senexger/shotexpress-spur-0/CAD/Track/preview/turnaround.jpg

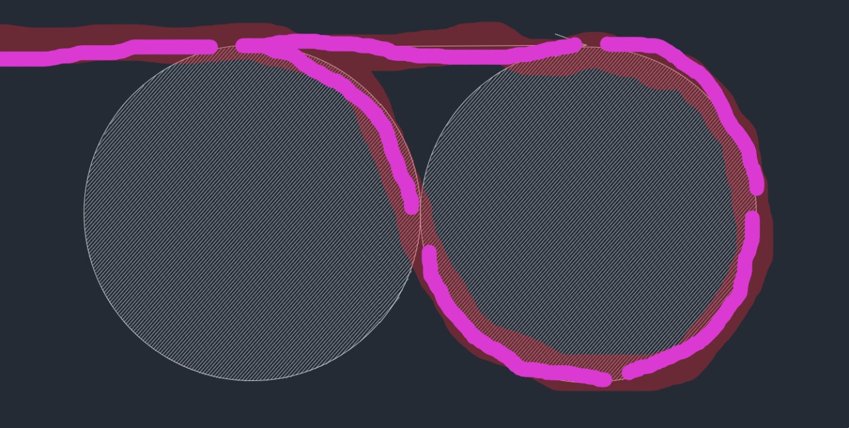
CAD/Track/preview/turnaround.jpg
