senexger/shotexpress-spur-0/CAD/Track/preview/weiche_change.png

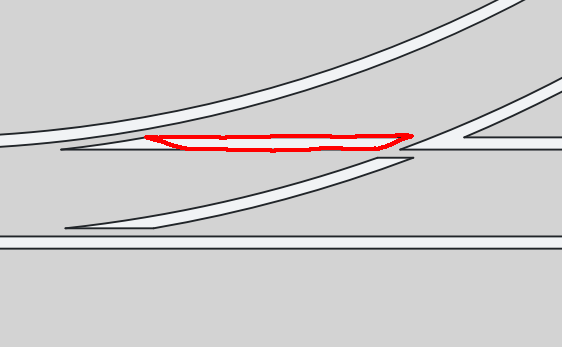
CAD/Track/preview/weiche_change.png
