senexger/shotexpress-spur-0/CAD/Wagon/coal_wagon_sketch.jpeg

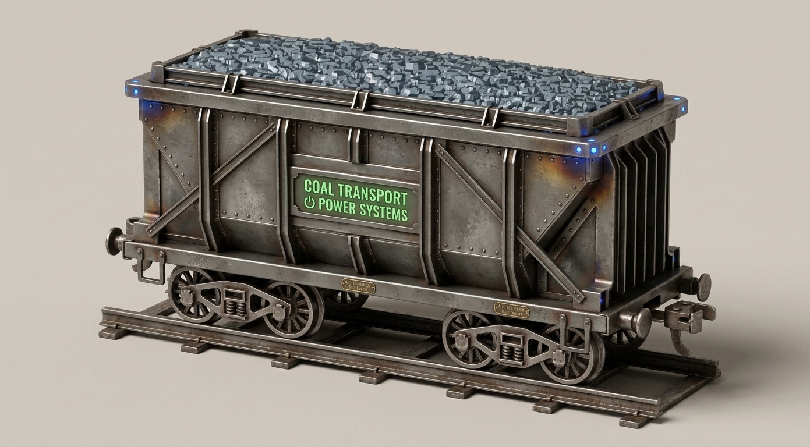
CAD/Wagon/coal_wagon_sketch.jpeg
