senexger/shotexpress-spur-0/CAD/Wagon/connector.jpg

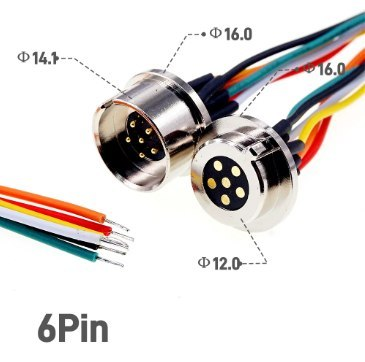
CAD/Wagon/connector.jpg
