senexger/shotexpress-spur-0/CAD/Wagon/flanschkugellager.jpg

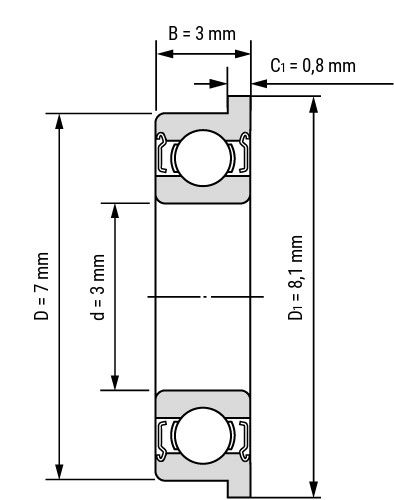
CAD/Wagon/flanschkugellager.jpg
