senexger/shotexpress-spur-0/CAD/Wagon/shot_wagon_sketch.jpeg

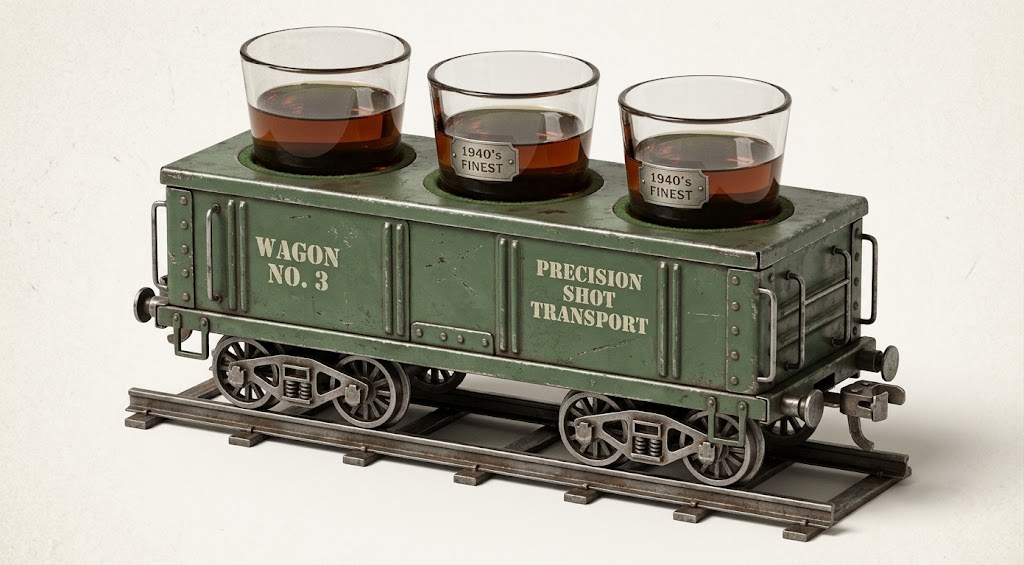
CAD/Wagon/shot_wagon_sketch.jpeg
