senexger/shotexpress-spur-0/CAD/Track/laser/kurve_90.dxf

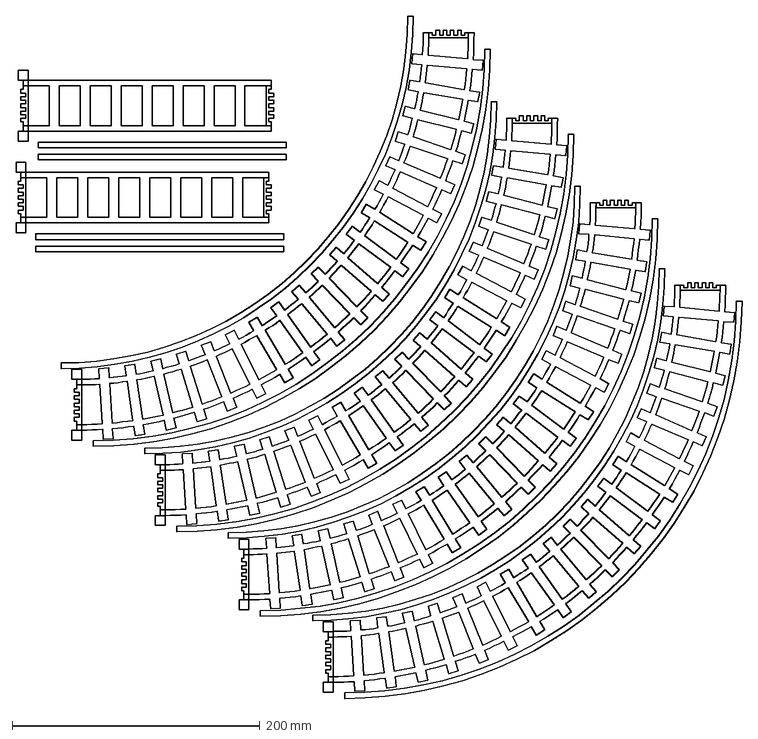
[picture p9: CAD file, 2026-11-03]
CAD/Track/laser/kurve_90.dxf
585.7 x 550.2 mm
