senexger/shotexpress-spur-0/CAD/Track/schiene.FCStd

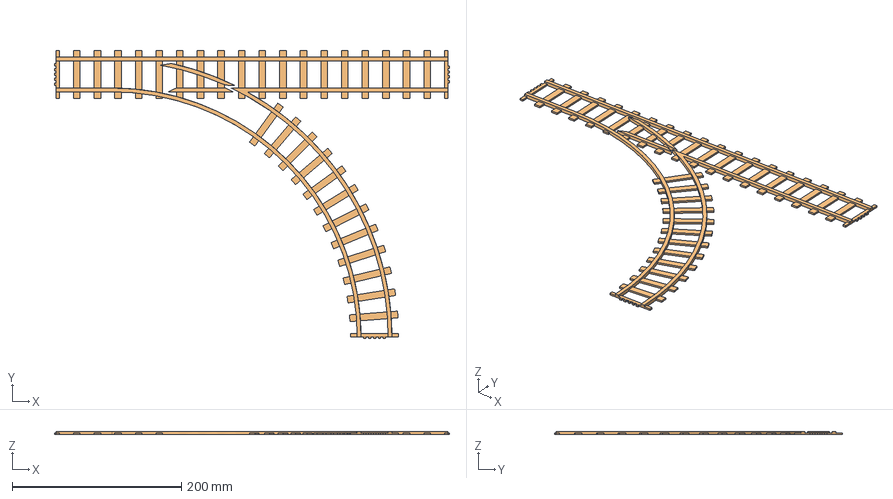
[picture p10: CAD file, 2026-11-03]
CAD/Track/schiene.FCStd
466.5 x 340.5 x 4.00 mm
Steckschwelle_male
