senexger/shotexpress-spur-0/CAD/Wagon/ModuleCoal.stl

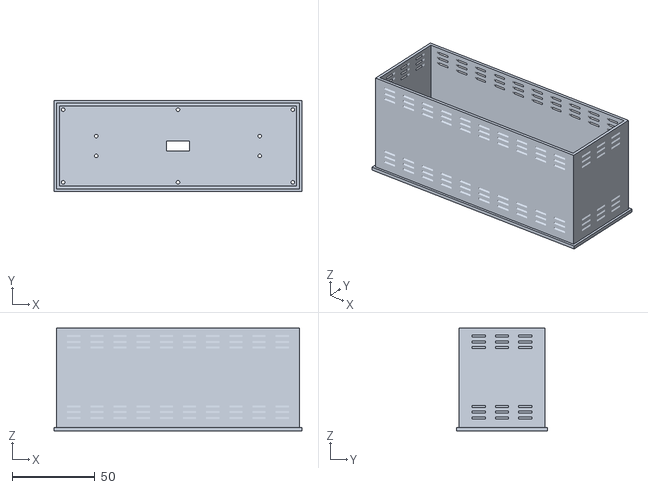
[picture p11: CAD file, 2026-11-03]
CAD/Wagon/ModuleCoal.stl
150.0 x 55.0 x 62.0
