senexger/shotexpress-spur-0/CAD/Wheelset/radsatz.FCStd

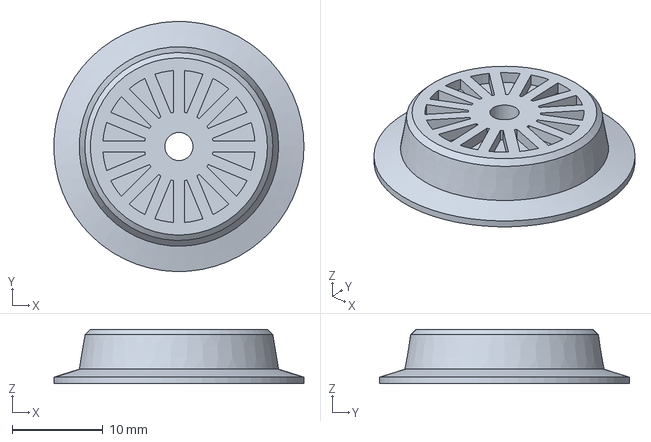
[picture p12: CAD file, 2026-11-03]
CAD/Wheelset/radsatz.FCStd
27.6 x 27.6 x 6.00 mm
