senexger/shotexpress-spur-0/CAD/Wheelset/stl/achse.stl

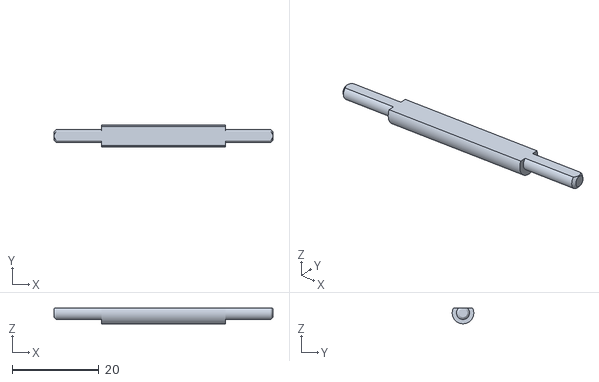
[picture p13: CAD file, 2026-11-03]
CAD/Wheelset/stl/achse.stl
50.6 x 5.00 x 3.60
