senexger/shotexpress-spur-0/CAD/Track/laser/gerade120.dxf

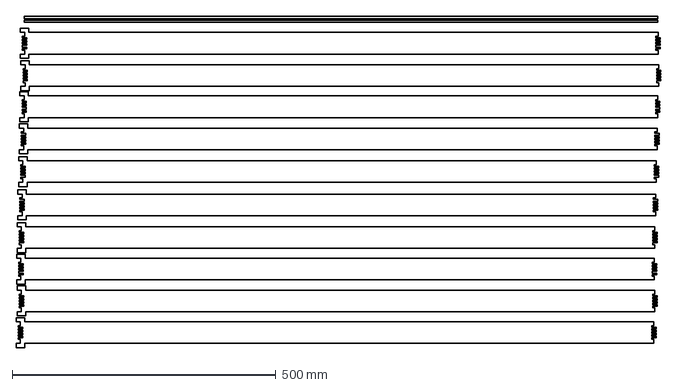
[picture p14: CAD file, 2026-11-03]
CAD/Track/laser/gerade120.dxf
1220.8 x 627.5 mm
