senexger/shotexpress-spur-0/CAD/Wagon/ModuleCoalLid.stl

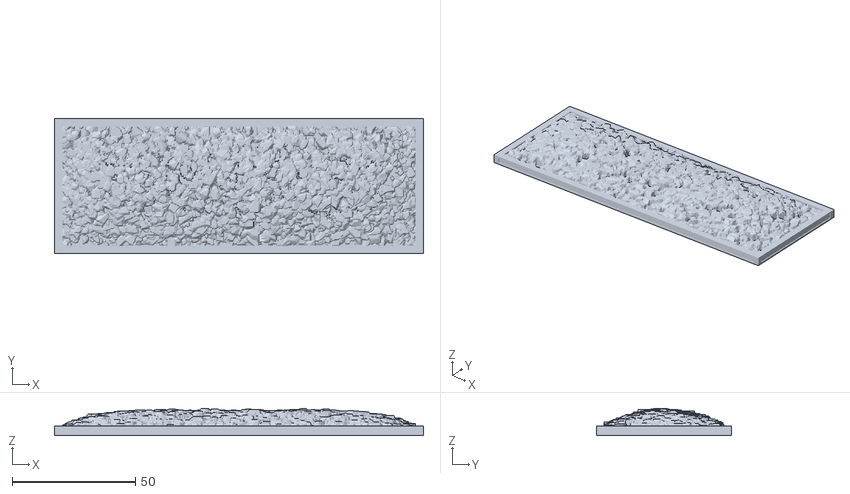
[picture p15: CAD file, 2026-11-03]
CAD/Wagon/ModuleCoalLid.stl
150.0 x 55.0 x 11.1
