senexger/shotexpress-spur-0/CAD/Wheelset/stl/radsatz-RadRad_Dekor_Vertiefung.stl

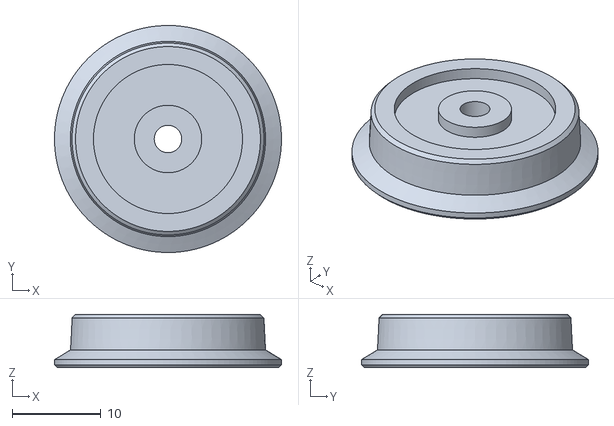
[picture p16: CAD file, 2026-11-03]
CAD/Wheelset/stl/radsatz-RadRad_Dekor_Vertiefung.stl
25.6 x 25.6 x 6.00
