senexger/shotexpress-spur-0/CAD/Track/laser/Kurve.dxf

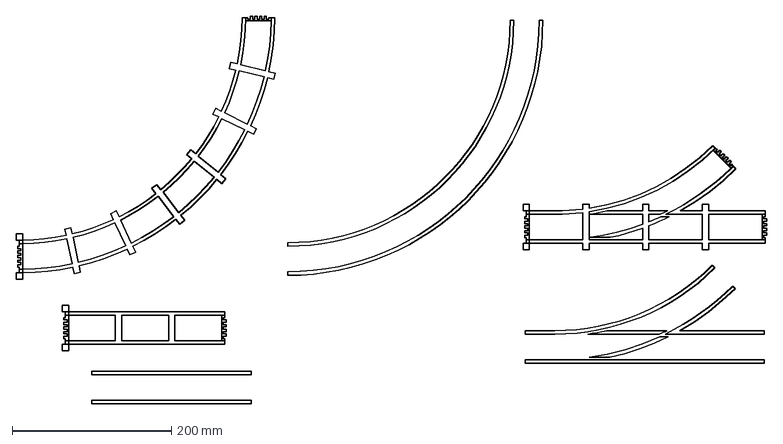
[picture p17: CAD file, 2026-11-03]
CAD/Track/laser/Kurve.dxf
942.2 x 486.9 mm
