senexger/shotexpress-spur-0/CAD/Wagon/ModuleCoal3Lid.stl

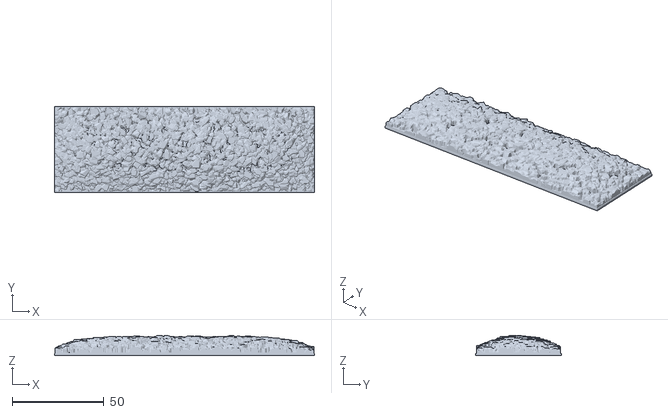
[picture p18: CAD file, 2026-11-03]
CAD/Wagon/ModuleCoal3Lid.stl
141.9 x 46.9 x 11.1
