senexger/shotexpress-spur-0/CAD/Wheelset/stl/radsatz-Rad.stl

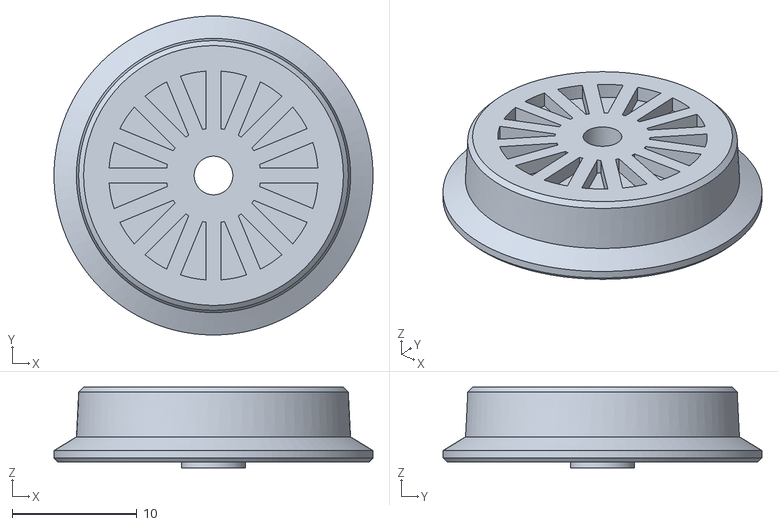
[picture p19: CAD file, 2026-11-03]
CAD/Wheelset/stl/radsatz-Rad.stl
25.6 x 25.6 x 6.50
