senexger/shotexpress-spur-0/CAD/Wagon/ModuleShot.stl

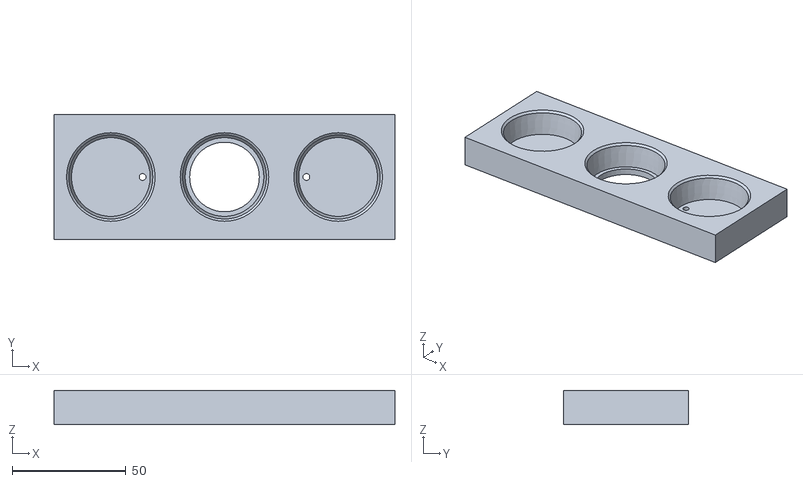
[picture p20: CAD file, 2026-11-03]
CAD/Wagon/ModuleShot.stl
150.0 x 55.0 x 15.0
