senexger/shotexpress-spur-0/CAD/Wheelset/stl/radsatz-Achse.stl

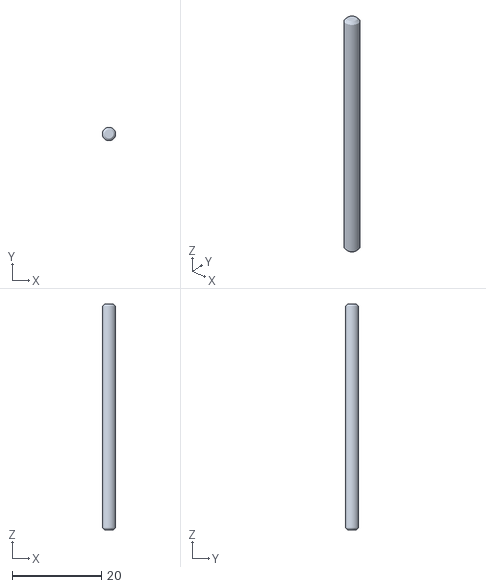
[picture p21: CAD file, 2026-11-03]
CAD/Wheelset/stl/radsatz-Achse.stl
3.00 x 3.00 x 50.6
