senexger/shotexpress-spur-0/CAD/Wagon/ModuleCoalDecorated.stl

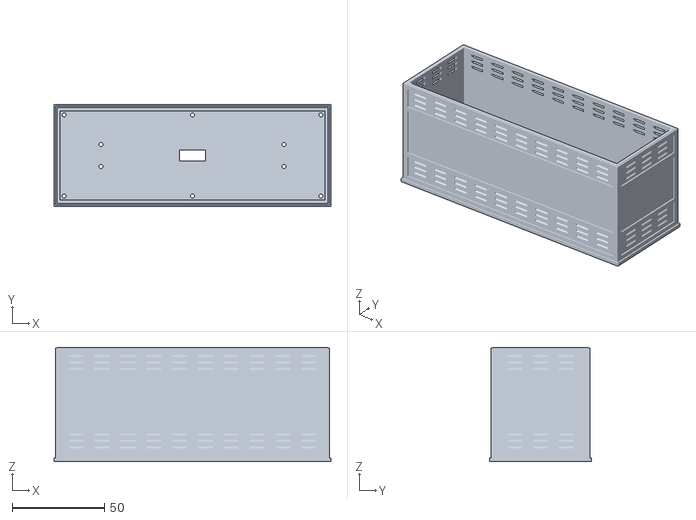
[picture p22: CAD file, 2026-11-03]
CAD/Wagon/ModuleCoalDecorated.stl
150.0 x 55.0 x 62.0
