senexger/shotexpress-spur-0/CAD/Wheelset/stl/rad.stl

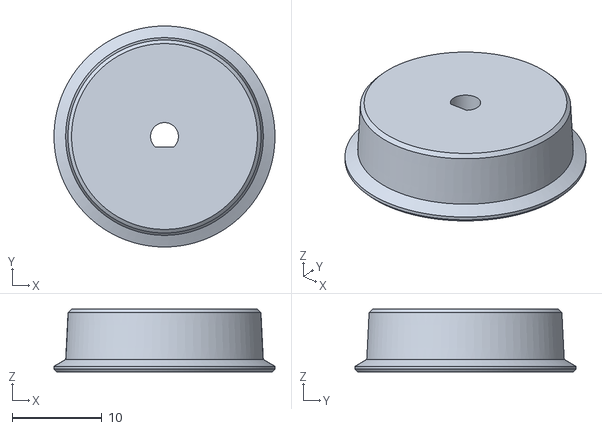
[picture p23: CAD file, 2026-11-03]
CAD/Wheelset/stl/rad.stl
24.6 x 24.6 x 7.00
