senexger/shotexpress-spur-0/CAD/Wagon/ModuleCoal3.step

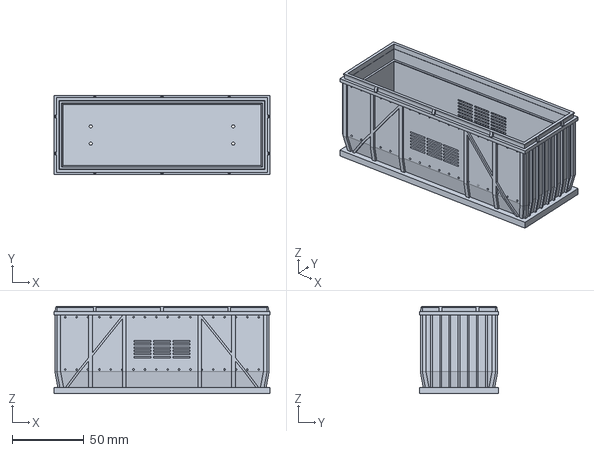
[picture p24: CAD file, 2026-11-03]
CAD/Wagon/ModuleCoal3.step
150.0 x 55.0 x 60.5 mm
