senexger/shotexpress-spur-0/CAD/Wagon/WagonBase-ModuleShot2.stl

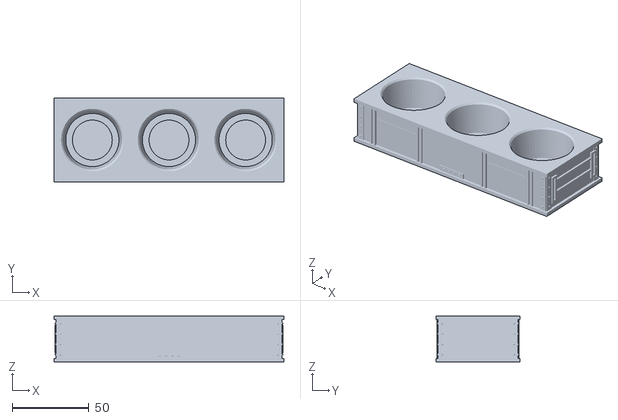
[picture p25: CAD file, 2026-11-03]
CAD/Wagon/WagonBase-ModuleShot2.stl
150.0 x 55.0 x 30.0
