senexger/shotexpress-spur-0/CAD/Wagon/ModulePlateBlank.stl

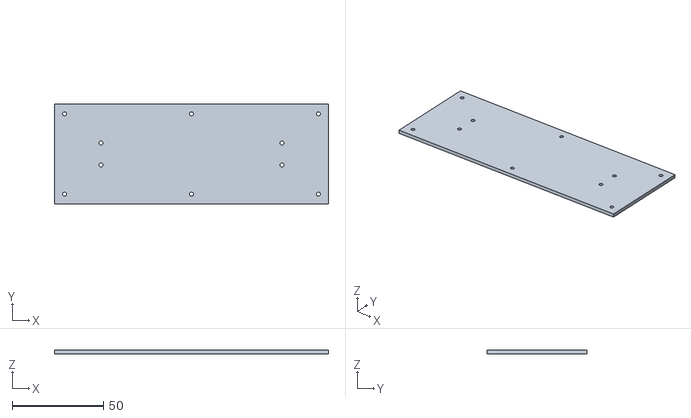
[picture p27: CAD file, 2026-11-03]
CAD/Wagon/ModulePlateBlank.stl
150.0 x 55.0 x 2.00
