senexger/shotexpress-spur-0/CAD/Wagon/WagonBase.step

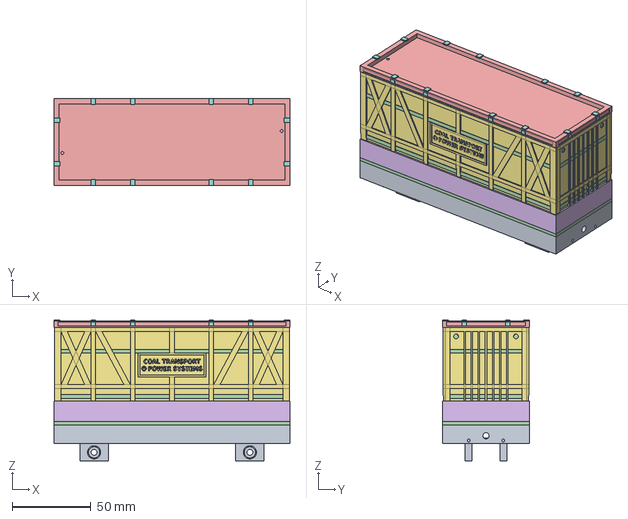
[picture p28: CAD file, 2026-11-03]
CAD/Wagon/WagonBase.step
150.0 x 55.0 x 89.6 mm
