senexger/shotexpress-spur-0/CAD/Wagon/HolderMale.stl

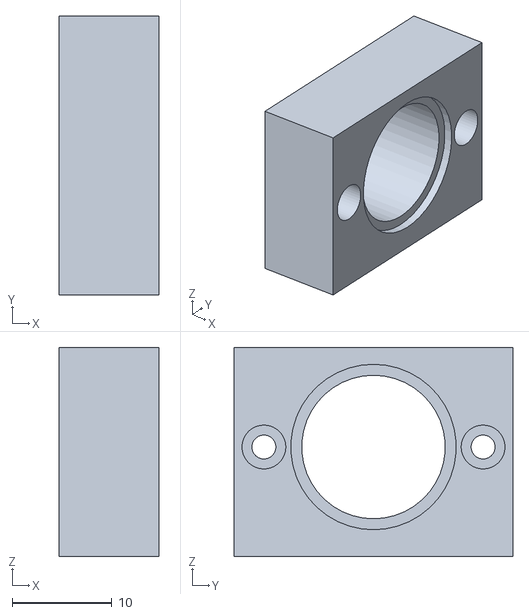
[picture p29: CAD file, 2026-10-19]
CAD/Wagon/HolderMale.stl
10.0 x 28.0 x 21.0
