senexger/shotexpress-spur-0/CAD/Wagon/ConnectorHolder.step

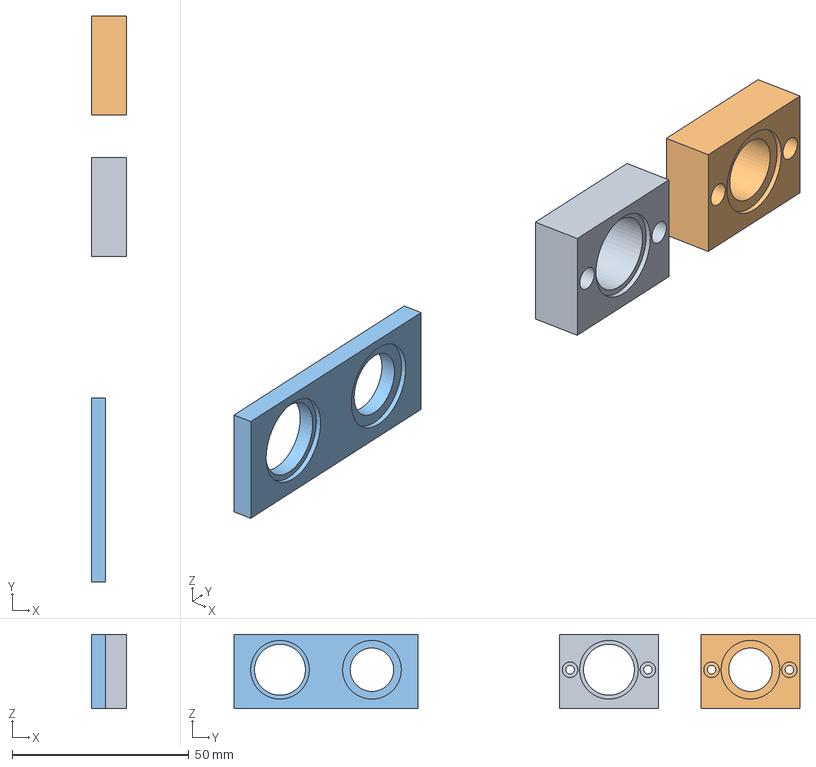
[picture p30: CAD file, 2026-10-19]
CAD/Wagon/ConnectorHolder.step
10.0 x 160.0 x 21.0 mm
