senexger/shotexpress-spur-0/CAD/Wagon/FitCoupon.stl

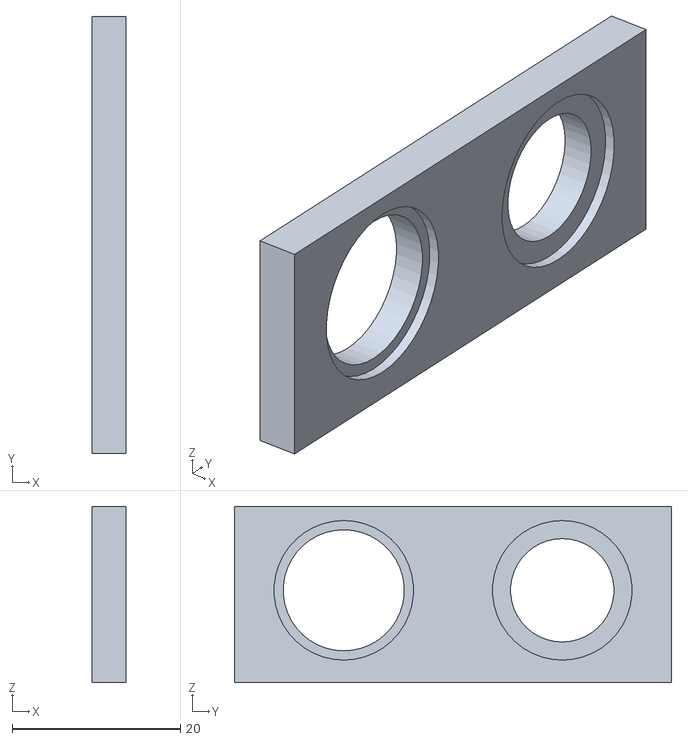
[picture p31: CAD file, 2026-10-19]
CAD/Wagon/FitCoupon.stl
4.00 x 52.0 x 21.0
