senexger/shotexpress-spur-0/(list of files, cad)

Other CAD files:
CAD/ShotExpressGear.FCStd
CAD/Wagon/ModuleCoal2Lid.stl
CAD/Wagon/ModuleShot2.step
CAD/Wagon/HolderFemale.stl
3D-Model/Wagon.blend
CAD/Wagon/ConnectorHolder.FCStd
CAD/Wagon/ModuleCoal3.FCStd
CAD/Wagon/ModuleCoal3.stl
CAD/Wagon/ModuleShot2.stl
CAD/Wagon/WagonBase.FCStd
CAD/Wagon/WagonBase.stl
