senexger/shotexpress-spur-0/server/src/assets.rs

use axum::http::header;
use axum::response::IntoResponse;

pub async fn admin_html() -> impl IntoResponse {
    (
        [(header::CONTENT_TYPE, "text/html; charset=utf-8")],
        include_str!("../assets/index.html"),
    )
}

pub async fn style_css() -> impl IntoResponse {
    (
        [(header::CONTENT_TYPE, "text/css; charset=utf-8")],
        include_str!("../assets/style.css"),
    )
}

pub async fn app_js() -> impl IntoResponse {
    (
        [(header::CONTENT_TYPE, "text/javascript; charset=utf-8")],
        include_str!("../assets/app.js"),
    )
}

pub async fn order_html() -> impl IntoResponse {
    (
        [(header::CONTENT_TYPE, "text/html; charset=utf-8")],
        include_str!("../assets/order.html"),
    )
}

pub async fn order_css() -> impl IntoResponse {
    (
        [(header::CONTENT_TYPE, "text/css; charset=utf-8")],
        include_str!("../assets/order.css"),
    )
}

pub async fn order_js() -> impl IntoResponse {
    (
        [(header::CONTENT_TYPE, "text/javascript; charset=utf-8")],
        include_str!("../assets/order.js"),
    )
}

pub async fn logo_svg() -> impl IntoResponse {
    (
        [
            (header::CONTENT_TYPE, "image/svg+xml"),
            (header::CACHE_CONTROL, "public, max-age=86400"),
        ],
        include_str!("../assets/logo.svg"),
    )
}

pub async fn banner_jpg() -> impl IntoResponse {
    (
        [
            (header::CONTENT_TYPE, "image/jpeg"),
            (header::CACHE_CONTROL, "public, max-age=86400"),
        ],
        include_bytes!("../assets/banner_image.jpg").as_slice(),
    )
}
