senexger/shotexpress-spur-0/(commit log)

2025-10-20 Init Shotexpress H-Bridge, ledc works
2025-10-21 Add webinterface and improve motor control
2025-11-16 feat: add faketrain for testing
    The current version of the software has a fake train that consumes
    events and publishes them to the topics specified in the README.md spec.
    The webserver is able to send the train to the raucherecke station, and
    to display status messages in a table.
    The real improvements happen under the hood though: I wrote down all zod
    schemas in schemas.ts and try to use them everywhere. The code feels
    good and sturdy from that perspective. I'd like to soon add linting,
    having a homogenous code style would help.
    In the mid-term, I want to see automated testing and a proper state
    machine in useTrainController that figures out how to properly control
    the train depending on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
2025-11-29 Jungernfahrt, mqtt, stepper
2026-05-17 Add 3D Model Template
    [Wagon.blend]
2026-07-03 Rewrite webserver as Rust: control server + shared protocol crate
    Replace the Next.js stack with a single-binary axum server (embedded
    static dashboard, SSE stream, rumqttc MQTT service) so deployment is one
    binary next to a .env instead of Node + pnpm. Wire types live in a new
    shotexpress-protocol crate at the root of a cargo workspace; a golden
    fixture generated from the TS createMoveCommand pins the JSON format,
    and side-by-side SSE diffing against the Next server verified
    byte-identical events. webserver/ stays until the Rust server is
    verified against the real train.
    The canonical .env now lives at the repo root (MQTT_URL/MQTT_USERNAME/
    MQTT_PASSWORD; NEXT_PUBLIC_* fallbacks are droppe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
2026-07-03 Add fake-train: ratatui train simulator, MQTT drop-in for the ESP32
    Virtual train for debugging the full chain without hardware: handles
    the JSON protocol (move_to routed by target, TTL/dedupe/cancel,
    APPROACH/DWELL/SAFE_STOP lifecycle) and the raw firmware integers
    0/1/2 (no exec events), publishing status heartbeats + exec events.
    The dogbone track (main line + turnaround loop per end) is modeled as
    a ring of 14 tag readings; the train's belief is computed only from
    tag reads + motor direction (unknown -> candidates -> localized after
    two consecutive tags, one for unique curve tags). The TUI draws the
    track with the moving [OOO] wagon, belief markers, ground-truth vs
    belief panels and an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
2026-10-19 server rewrite, train debug, cad design begin
2026-11-03 Rework Server, add CAD
